LDdd130/Elevater/Elevator_working_ver/asset/image.png

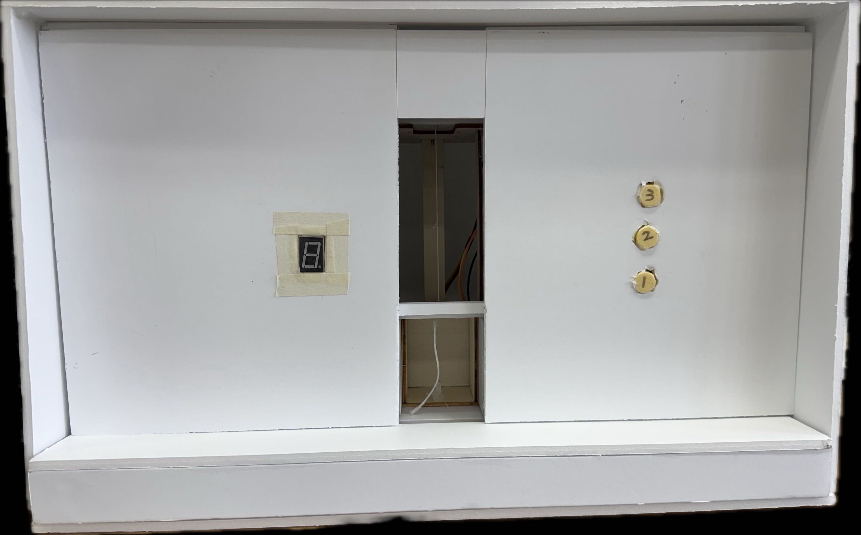
Elevator_working_ver/asset/image.png
