LDdd130/Elevater/Elevator_working_ver/Core/Src/main.c

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
/* Includes ------------------------------------------------------------------*/
#include "main.h"
#include "tim.h"
#include "usart.h"
#include "gpio.h"

/* USER CODE BEGIN Includes */
#include "fnd.h"
#include "buzzer.h"
#include "door.h"
/* USER CODE END Includes */

/* USER CODE BEGIN PTD */

enum elevator_floor{
	First_floor = 1,
	Second_floor,
	Third_floor,
	fourth
};
uint8_t flag = 0;


/* USER CODE END PTD */


void SystemClock_Config(void);
/**
  * @brief  The application entry point.
  * @retval int
  */
int main(void)
{

  /* MCU Configuration--------------------------------------------------------*/

  /* Reset of all peripherals, Initializes the Flash interface and the Systick. */
  HAL_Init();

  /* Configure the system clock */
  SystemClock_Config();

  /* Initialize all configured peripherals */
  MX_GPIO_Init();
  MX_TIM3_Init();
  MX_TIM4_Init();
  MX_TIM11_Init();
  MX_USART1_UART_Init();
  MX_USART2_UART_Init();
  /* USER CODE BEGIN 2 */

  HAL_TIM_PWM_Start(&htim11, TIM_CHANNEL_1);

  /* USER CODE END 2 */

  /* Infinite loop */
  /* USER CODE BEGIN WHILE */
  while (1)
  {
	  update_buzzer_nonblocking();
	  update_door_nonblocking();

	  if(HAL_GPIO_ReadPin(GPIOC, GPIO_PIN_9) != GPIO_PIN_SET)
	  {
		  fourth_floor_fnd();

		  open_door_request();

		  flag = fourth;
	  }
	  else if((HAL_GPIO_ReadPin(GPIOC, GPIO_PIN_8) != GPIO_PIN_SET) && (flag != Third_floor))
	  {
		  third_floor_fnd();

		  start_floor_buzzer(255);

		  open_door_request();

  		  flag = Third_floor;
	  }
	  else if((HAL_GPIO_ReadPin(GPIOC, GPIO_PIN_6) != GPIO_PIN_SET) && (flag != Second_floor))
	  {
		  second_floor_fnd();

		  start_floor_buzzer(304);

		  open_door_request();

		  flag = Second_floor;
	  }
	  else if((HAL_GPIO_ReadPin(GPIOC, GPIO_PIN_5) != GPIO_PIN_SET) && (flag != First_floor))
	  {
		  first_floor_fnd();

		  start_floor_buzzer(383);

		  open_door_request();

		  flag = First_floor;
	  }
    /* USER CODE END WHILE */

    /* USER CODE BEGIN 3 */
  }
  /* USER CODE END 3 */
}

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
