LDdd130/Elevater/Elevator_working_ver/Core/Src/fnd.c

#include "fnd.h"

void clear_fnd(void)
{
	HAL_GPIO_WritePin(GPIOA, GPIO_PIN_12, GPIO_PIN_RESET);	// A
	HAL_GPIO_WritePin(GPIOA, GPIO_PIN_11, GPIO_PIN_RESET);	// B
	HAL_GPIO_WritePin(GPIOB, GPIO_PIN_12, GPIO_PIN_RESET);	// C
	HAL_GPIO_WritePin(GPIOA, GPIO_PIN_8, GPIO_PIN_RESET);	// D
	HAL_GPIO_WritePin(GPIOB, GPIO_PIN_10, GPIO_PIN_RESET);	// E
	HAL_GPIO_WritePin(GPIOB, GPIO_PIN_4, GPIO_PIN_RESET);	// F
	HAL_GPIO_WritePin(GPIOB, GPIO_PIN_5, GPIO_PIN_RESET);	// G
}

void first_floor_fnd()
{
	clear_fnd();	// FND 클리어
	HAL_GPIO_WritePin(GPIOA, GPIO_PIN_11, GPIO_PIN_SET);	// B
	HAL_GPIO_WritePin(GPIOB, GPIO_PIN_12, GPIO_PIN_SET);	// C
}

void second_floor_fnd()
{
	clear_fnd();
	HAL_GPIO_WritePin(GPIOA, GPIO_PIN_12, GPIO_PIN_SET);	// A
	HAL_GPIO_WritePin(GPIOA, GPIO_PIN_11, GPIO_PIN_SET);	// B
	HAL_GPIO_WritePin(GPIOB, GPIO_PIN_10, GPIO_PIN_SET);	// E
	HAL_GPIO_WritePin(GPIOA, GPIO_PIN_8, GPIO_PIN_SET);		// D
	HAL_GPIO_WritePin(GPIOB, GPIO_PIN_5, GPIO_PIN_SET);		// G
}

void third_floor_fnd()
{
	clear_fnd();
	HAL_GPIO_WritePin(GPIOA, GPIO_PIN_12, GPIO_PIN_SET);	// A
	HAL_GPIO_WritePin(GPIOA, GPIO_PIN_11, GPIO_PIN_SET);	// B
	HAL_GPIO_WritePin(GPIOB, GPIO_PIN_12, GPIO_PIN_SET);	// C
	HAL_GPIO_WritePin(GPIOA, GPIO_PIN_8, GPIO_PIN_SET);	// D
	HAL_GPIO_WritePin(GPIOB, GPIO_PIN_5, GPIO_PIN_SET);	// G
}

void fourth_floor_fnd()
{
	clear_fnd();
	HAL_GPIO_WritePin(GPIOA, GPIO_PIN_11, GPIO_PIN_SET);	// B
	HAL_GPIO_WritePin(GPIOB, GPIO_PIN_12, GPIO_PIN_SET);	// C
	HAL_GPIO_WritePin(GPIOB, GPIO_PIN_4, GPIO_PIN_SET);	// F
	HAL_GPIO_WritePin(GPIOB, GPIO_PIN_5, GPIO_PIN_SET);	// G
}
