LDdd130/Elevater/(commit log)

2026-08-15 Update README with detailed system architecture and features
    Refine README details on sensor filtering, stepper control, and Bluetooth display protocol.
2026-08-25 Enhance README with source tree and control flow details
    Updated README to include source tree guidance and control flow diagrams.
